ciaranmoore/TentaSense/Datasheets/ESP32 Thing Plus Pins.jpeg

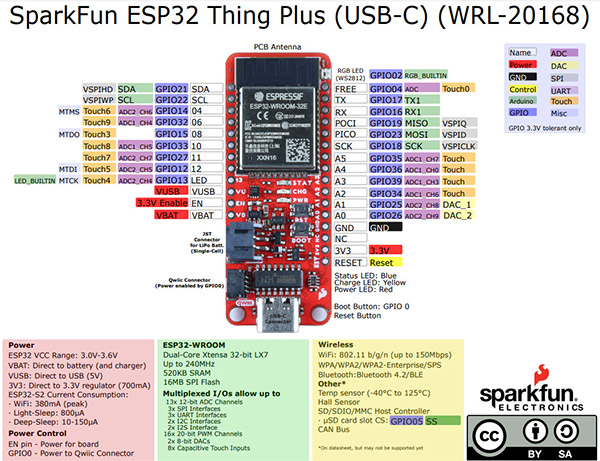
Datasheets/ESP32 Thing Plus Pins.jpeg
