ciaranmoore/TentaSense/Current Consumption/Sleep - 2.91 mAh:h.png

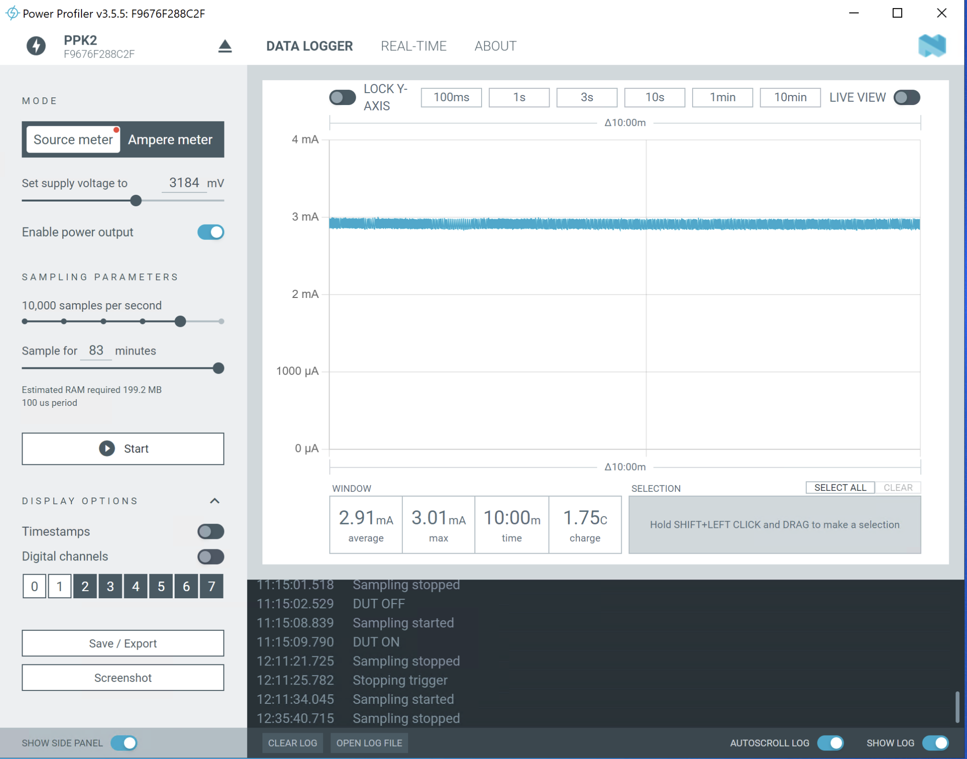
Current Consumption/Sleep - 2.91 mAh:h.png
