ciaranmoore/TentaSense/Current Consumption/Start-up - 0.6 mAh.png

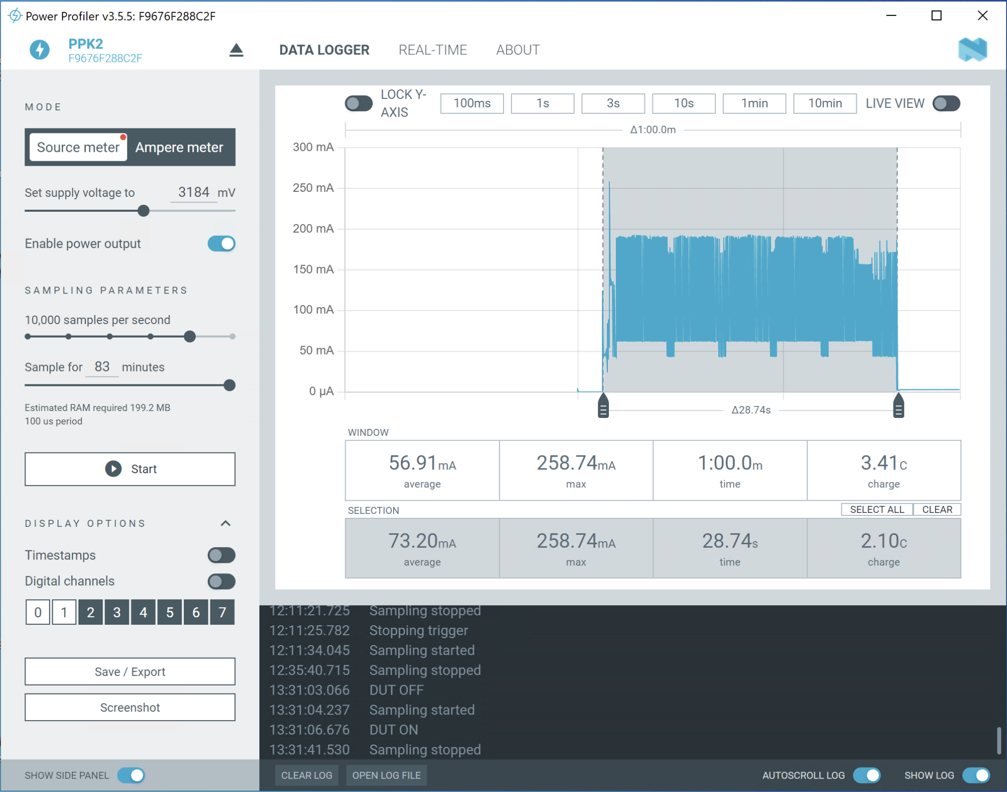
Current Consumption/Start-up - 0.6 mAh.png
