ciaranmoore/TentaSense/PCB/esp32-cp2102-programmer-schematic-for-espressif-esp32-esp8266.jpg

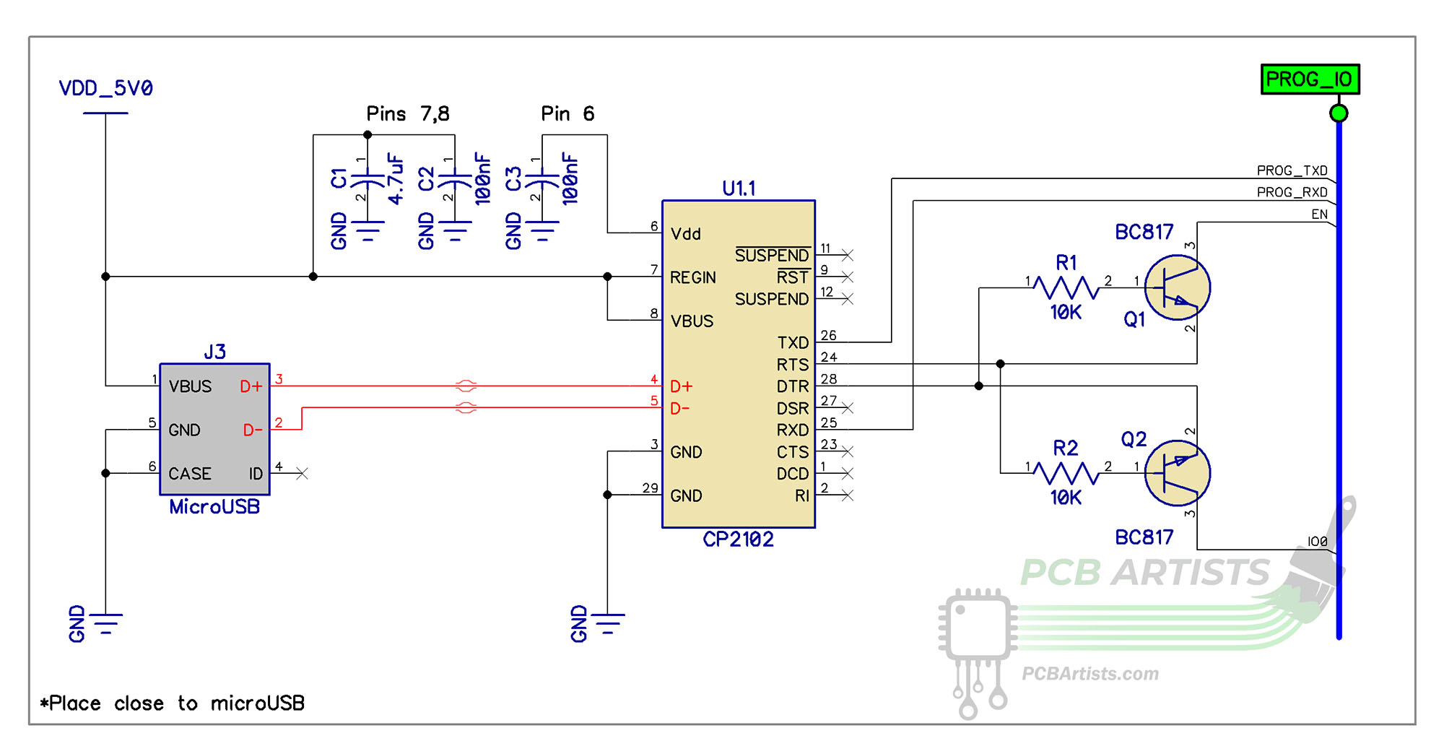
PCB/esp32-cp2102-programmer-schematic-for-espressif-esp32-esp8266.jpg
