ciaranmoore/TentaSense/PCB/Orchid.png

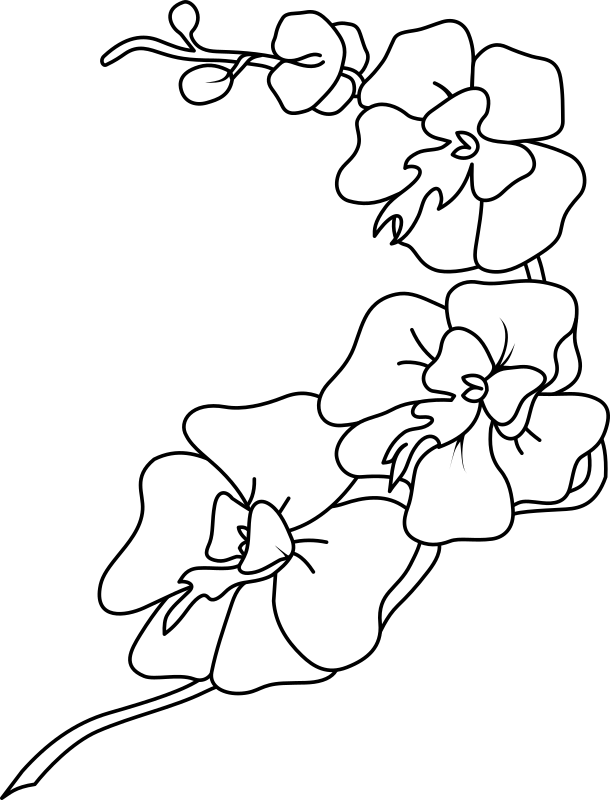
PCB/Orchid.png
