ciaranmoore/TentaSense/PCB/Footprints/ESP32-WROOM-32E__16MB_/ESP32-WROOM-32E__16MB_.step

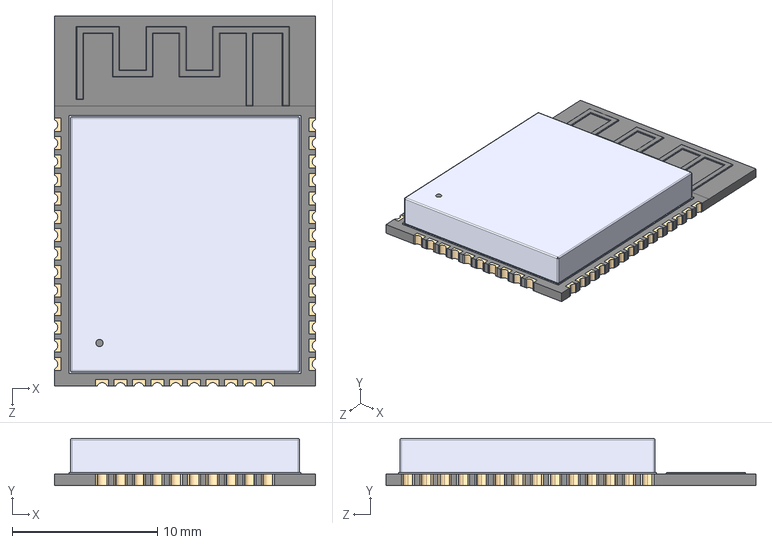
[picture p6: CAD file, 2024-07-01]
PCB/Footprints/ESP32-WROOM-32E__16MB_/ESP32-WROOM-32E__16MB_.step
18.0 x 3.25 x 25.5 mm
