ciaranmoore/TentaSense/PCB/Footprints/TL3305AF160QG/TL3305AF160QG.step

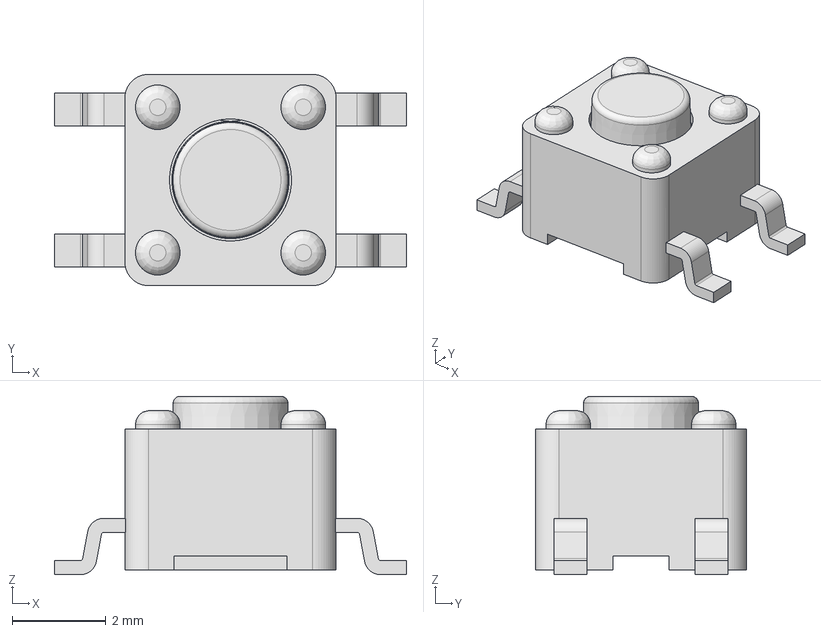
[picture p7: CAD file, 2024-07-01]
PCB/Footprints/TL3305AF160QG/TL3305AF160QG.step
7.50 x 4.50 x 3.80 mm
