ciaranmoore/TentaSense/Current Consumption/Current Measurement Method.rtf

Current consumption measurements taken for ESP32 Thing Plus C board powered at 3.184 V, connected to 3 × Adafruit AHT20 boards (with green LEDs).
Nordic PPK2 used in Source Meter mode.
Red power LED of the Thing Plus C is disabled.
