ciaranmoore/TentaSense/Current Consumption/Measurement - 12.3µAh.png

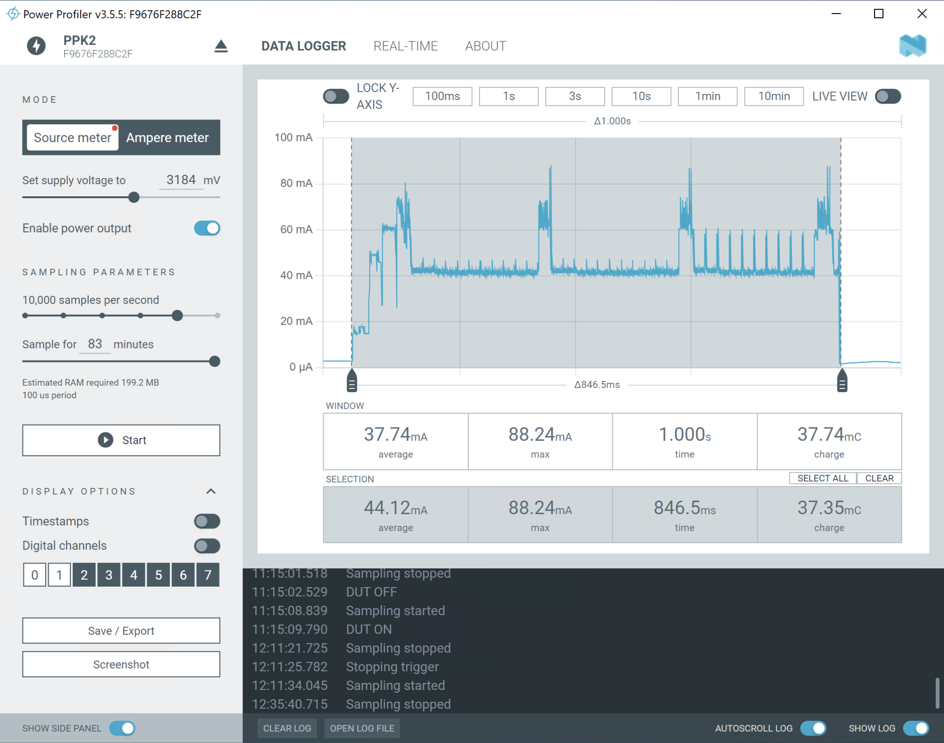
Current Consumption/Measurement - 12.3µAh.png
