ciaranmoore/TentaSense/PCB/RBOP04/Rigid Schematic.pdf

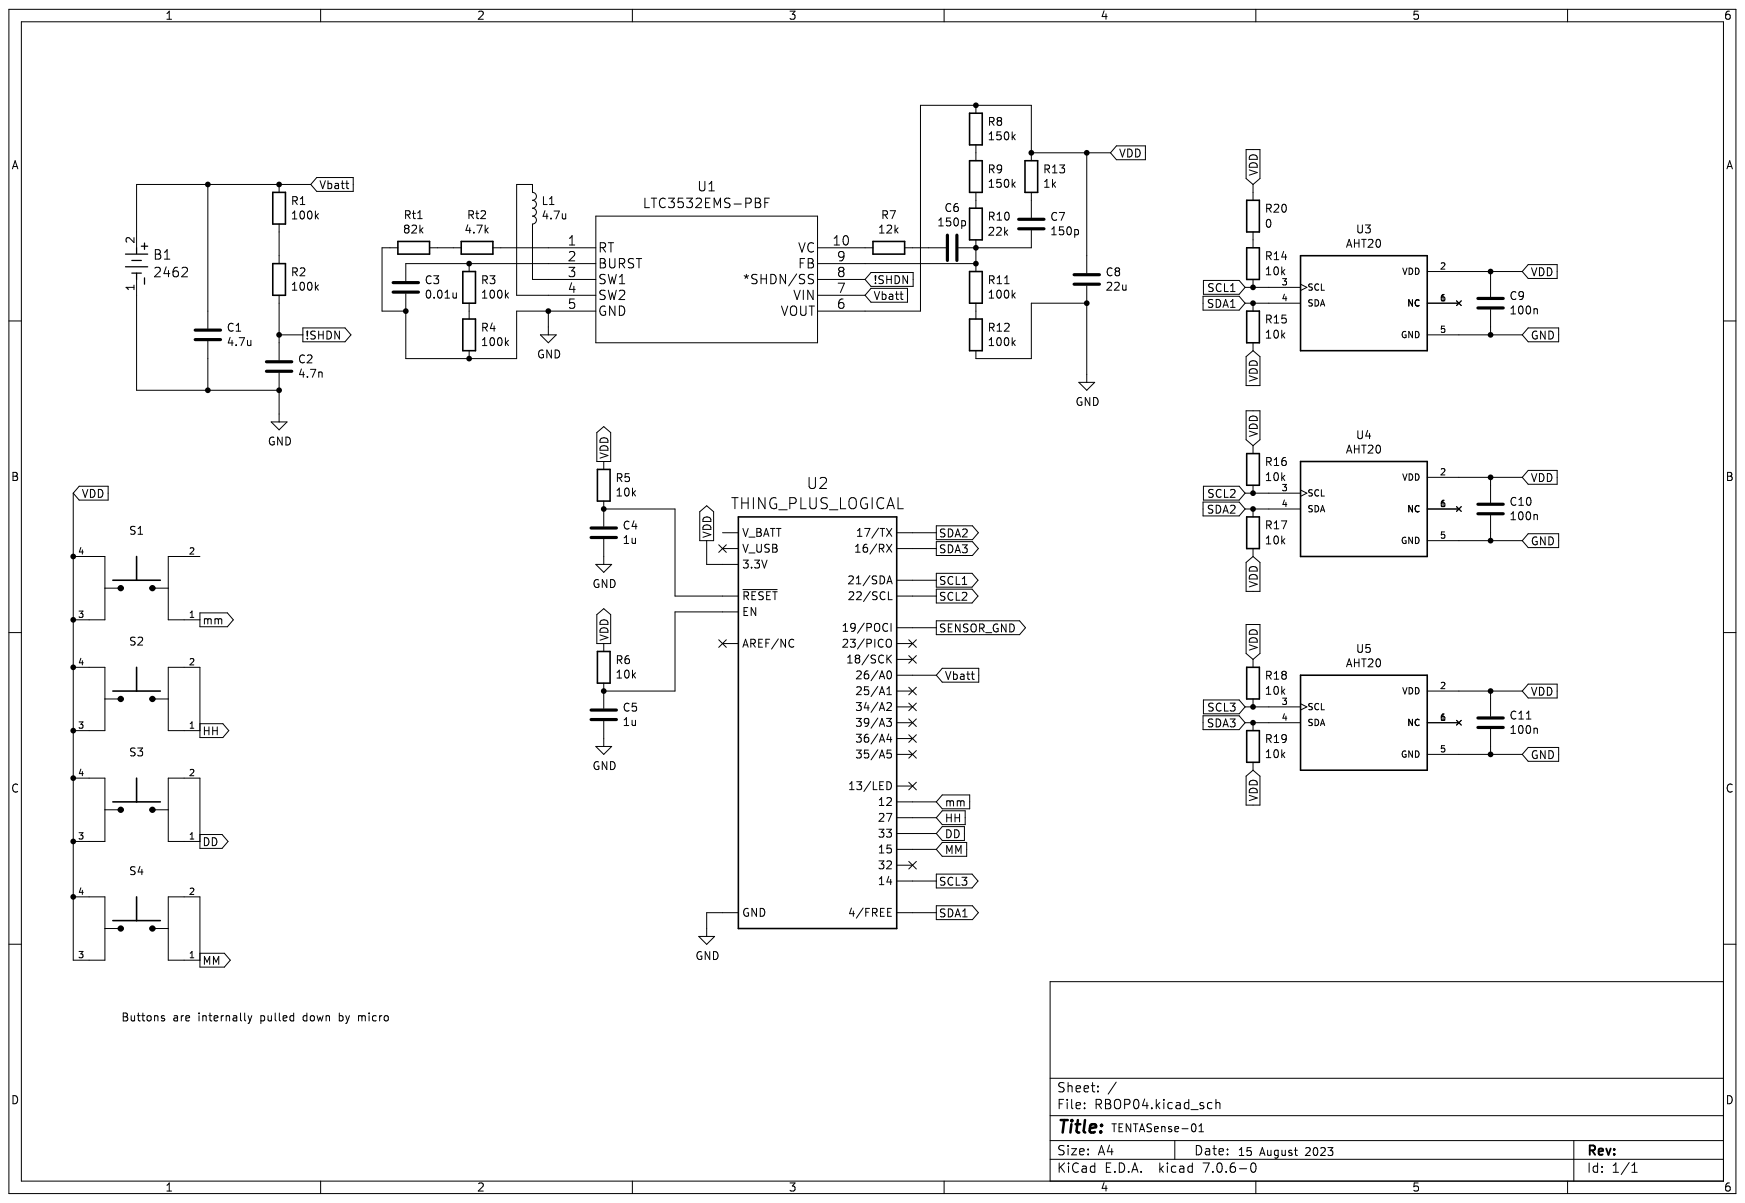
[picture p9: page 1]
