ciaranmoore/TentaSense/PCB/RBOP04_Flexible/Flexible Schematic.pdf

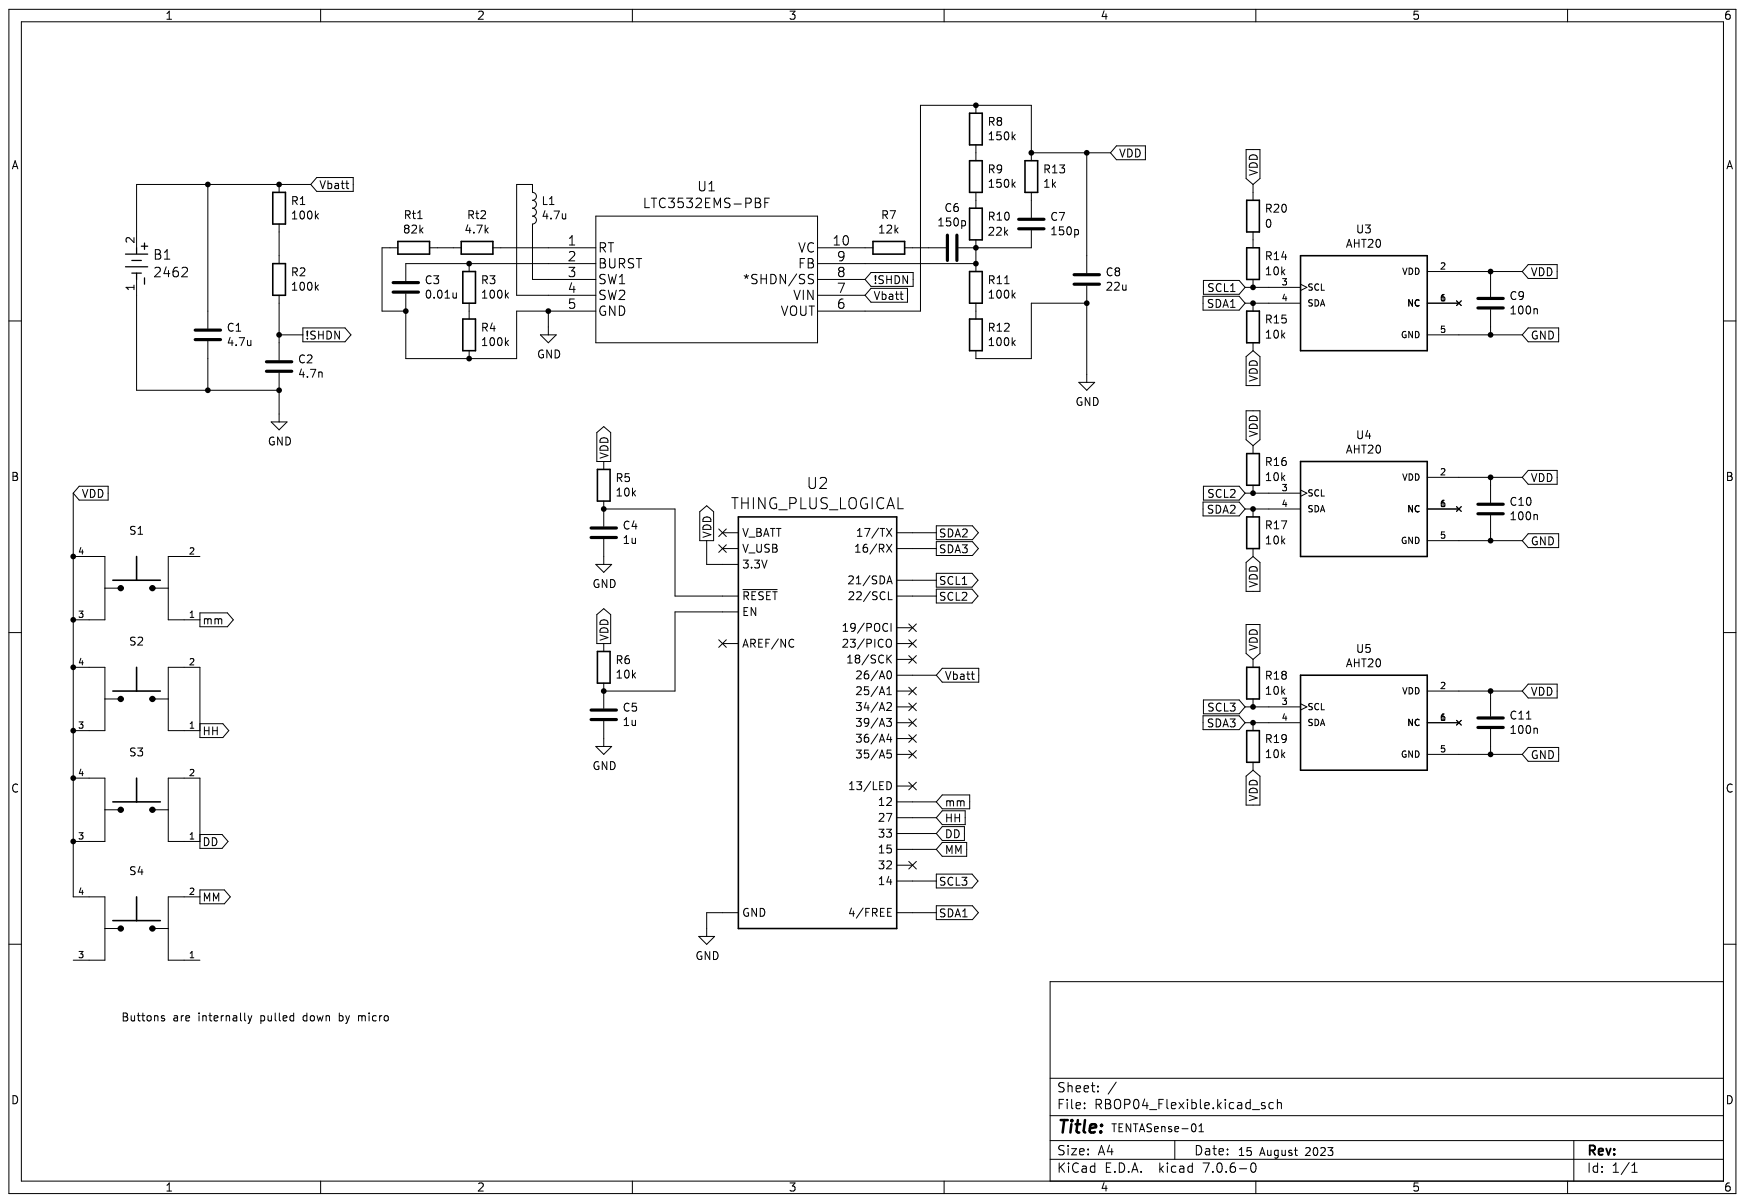
[picture p10: page 1]
