ciaranmoore/TentaSense/PCB/RBOP04/Rigid Layout.pdf

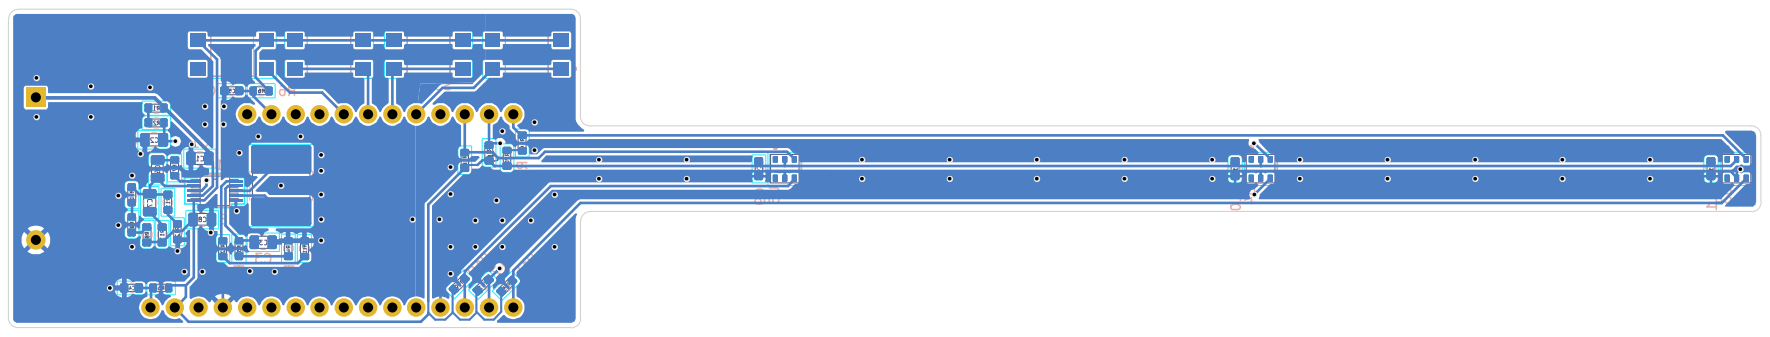
[picture p11: page 1]
