ciaranmoore/TentaSense/PCB/RBOP04_Flexible/Flexible Layout - Back.pdf

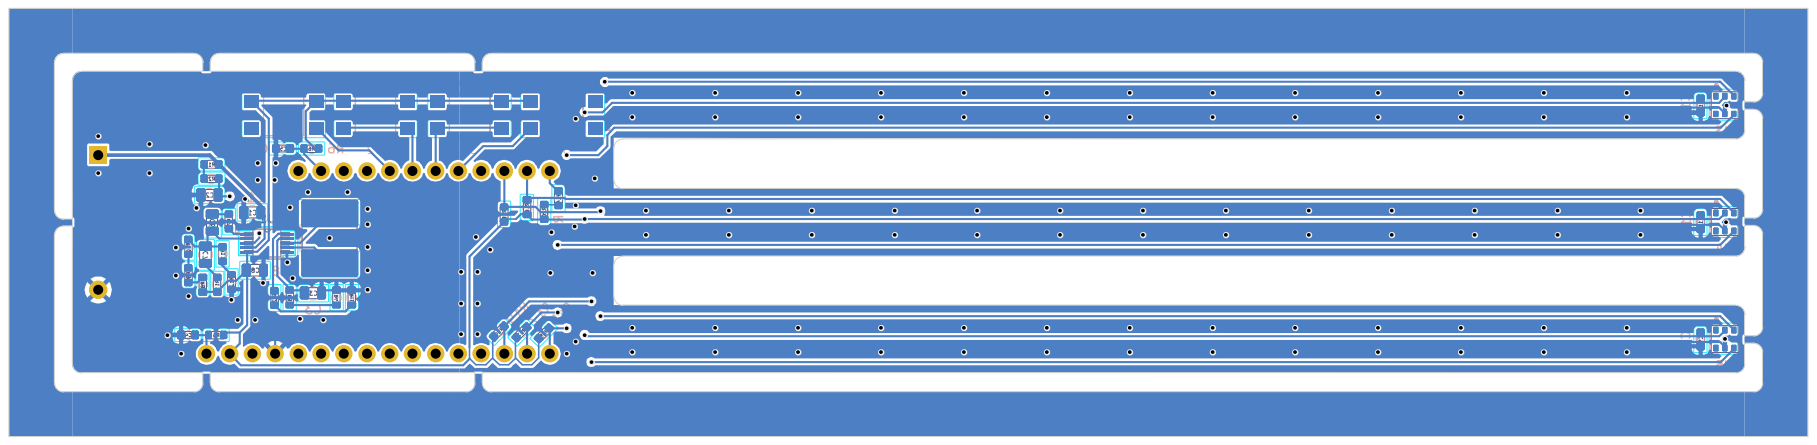
[picture p12: page 1]
