ciaranmoore/TentaSense/PCB/RBOP04_Flexible/Flexible Layout - Front.pdf

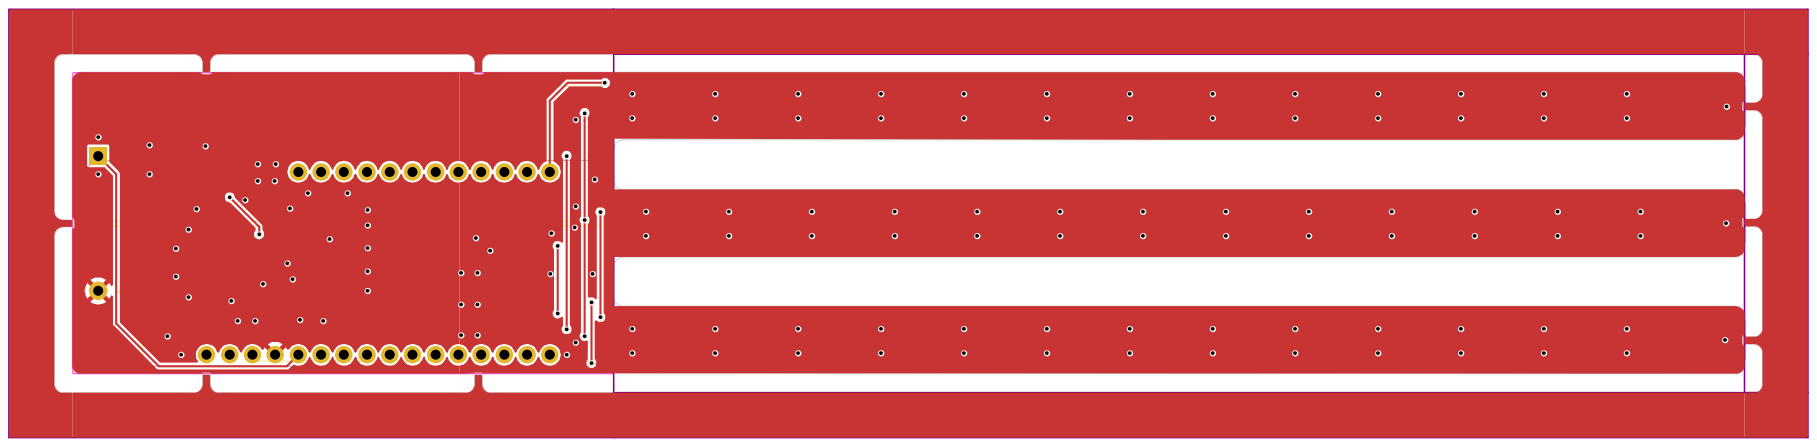
[picture p13: page 1]
