ciaranmoore/TentaSense/LTspice/LTC3532.asc

C1: cap; 4.7µ
C2: cap; 150p
C3: cap; 47µ
C4: cap; 150p
C5: cap; 4.7n
C6: cap; 22n
L1: ind; 4.7µ; Rser=26m
R1: res; 300k
R1a: res; {Rv}
R2: res; 200k
R3: res; 200k
R6: res; 12.1k
R7: res; 200k
R9: res; 1k
Rload: res; {RLOAD}
Rt: res; 86.6k
U1: LTC3532
V1: battery; {DCV}
Named nets: 0
.tran 0 3m 1m
Vout = 1.22V × (R8 + R9 + R5) / R5
.step param DCV list 2.7 3 3.3
.step param RLOAD list 1098, 33
.step param RLOAD list 2.5mA, 2.7mA, 3mA, 40mA, 60mA, 100mA
.step param DCV list 3 3.7
.PARAM RLOAD 1098
.step lin param RLOAD 100 1000 450
.param DCV 2.5
.step param Rv 22k 27k 5k
