ciaranmoore/TentaSense/PCB/RBOP04_Flexible/RBOP04_Flexible.kicad_pcb

## KiCad design PCB/RBOP04_Flexible/RBOP04_Flexible.kicad_pcb (2024-07-01)

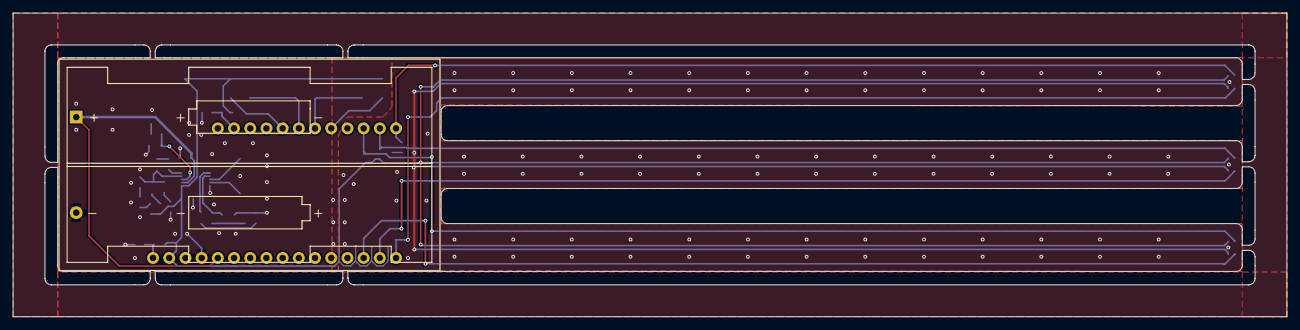
[picture p14: board RBOP04_Flexible.kicad_pcb from above]

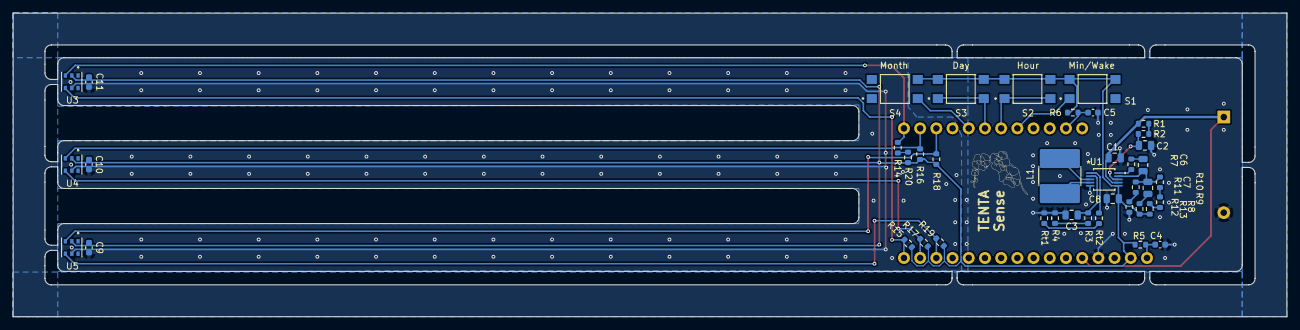
[picture p15: board RBOP04_Flexible.kicad_pcb from below]

Board: 2 copper layers, 199.7 x 47.6 mm, 44 parts (42 on the bottom side), 31 nets.

Parts:
B1: 2462; BatteryHolder_Keystone_2462_2xAA_CM
C1: 4.7u; C_0805_2012Metric
C2: 4.7n; C_0805_2012Metric
C3: 0.01u; C_0805_2012Metric
C4, C5: 1u; C_0603_1608Metric
C6, C7: 150p; C_0805_2012Metric
C8: 22u; C_0805_2012Metric
C9, C10, C11: 100n; C_0603_1608Metric
L1: 4.7u; L_2424_6060Metric
R1, R2, R3, R4, R11, R12: 100k; R_0603_1608Metric
R5, R6, R14, R15, R16, R17, R18, R19: 10k; R_0603_1608Metric
R7: 12k; R_0603_1608Metric
R8, R9: 150k; R_0603_1608Metric
R10: 22k; R_0603_1608Metric
R13: 1k; R_0603_1608Metric
R20: 0; R_0603_1608Metric
Rt1: 82k; R_0603_1608Metric
Rt2: 4.7k; R_0603_1608Metric
S1, S2, S3, S4: TL3305AF160QG; Button-CM
U1: LTC3532EMS-PBF; MSOP-10_MS_LIT
U2: THING_PLUS_LOGICAL; ESP32_Thing_Plus_C_hat
U3, U4, U5: AHT20; PSON100P300X300X110-6N

Connections:
!SHDN: C2.1, R2.2, U1.8 (*SHDN/SS)
DD: S3.1, S3.2, U2.6 (33)
GND: B1.1, C1.2, C2.2, C3.2, C4.2, C5.2, C8.2, C9.2, C10.2, C11.2, R4.2, R12.2, Rt1.2, U1.5 (GND), U2.25 (GND), U3.5 (GND), U4.5 (GND), U5.5 (GND)
HH: S2.1, S2.2, U2.7 (27)
MM: S4.2, U2.5 (15)
unnamed: C6.2, R7.1
unnamed: C7.1, R13.2
unnamed: R1.2, R2.1
unnamed: R3.2, R4.1
unnamed: R8.2, R9.1
unnamed: R9.2, R10.1
unnamed: R11.2, R12.1
unnamed: R14.1, R20.2
unnamed: Rt1.1, Rt2.2
unnamed: C3.1, R3.1, U1.2 (BURST)
unnamed: C6.1, C7.2, R10.2, R11.1, U1.9 (FB)
unnamed: Rt2.1, U1.1 (RT)
unnamed: L1.2, U1.3 (SW1)
unnamed: L1.1, U1.4 (SW2)
unnamed: R7.2, U1.10 (VC)
unnamed: C5.1, R6.2, U2.11 (EN)
unnamed: C4.1, R5.2, U2.28 (~RESET)
SCL1: R14.2, U2.1 (21/SDA), U3.3 (SCL)
SCL2: R16.2, U2.2 (22/SCL), U4.3 (SCL)
SCL3: R18.2, U2.3 (14), U5.3 (SCL)
SDA1: R15.1, U2.13 (4/FREE), U3.4 (SDA)
SDA2: R17.1, U2.14 (17/TX), U4.4 (SDA)
SDA3: R19.1, U2.15 (16/RX), U5.4 (SDA)
VDD: C8.1, C9.1, C10.1, C11.1, R5.1, R6.1, R8.1, R13.1, R15.2, R16.1, R17.2, R18.1, R19.2, R20.1, S1.3, S1.4, S2.3, S2.4, S3.3, S3.4, S4.4, U1.6 (VOUT), U2.27 (3.3V), U3.2 (VDD), U4.2 (VDD), U5.2 (VDD)
Vbatt: B1.2, C1.1, R1.1, U1.7 (VIN), U2.24 (26/A0)
mm: S1.1, U2.8 (12)
