ciaranmoore/TentaSense/PCB/Footprints/SparkFun_Thing_Plus_ESP32_WROOM_C_eagle_files2/SparkFun_Thing_Plus_ESP32_WROOM_C.brd

## EAGLE design PCB/Footprints/SparkFun_Thing_Plus_ESP32_WROOM_C_eagle_files2/SparkFun_Thing_Plus_ESP32_WROOM_C.brd (2024-07-01)

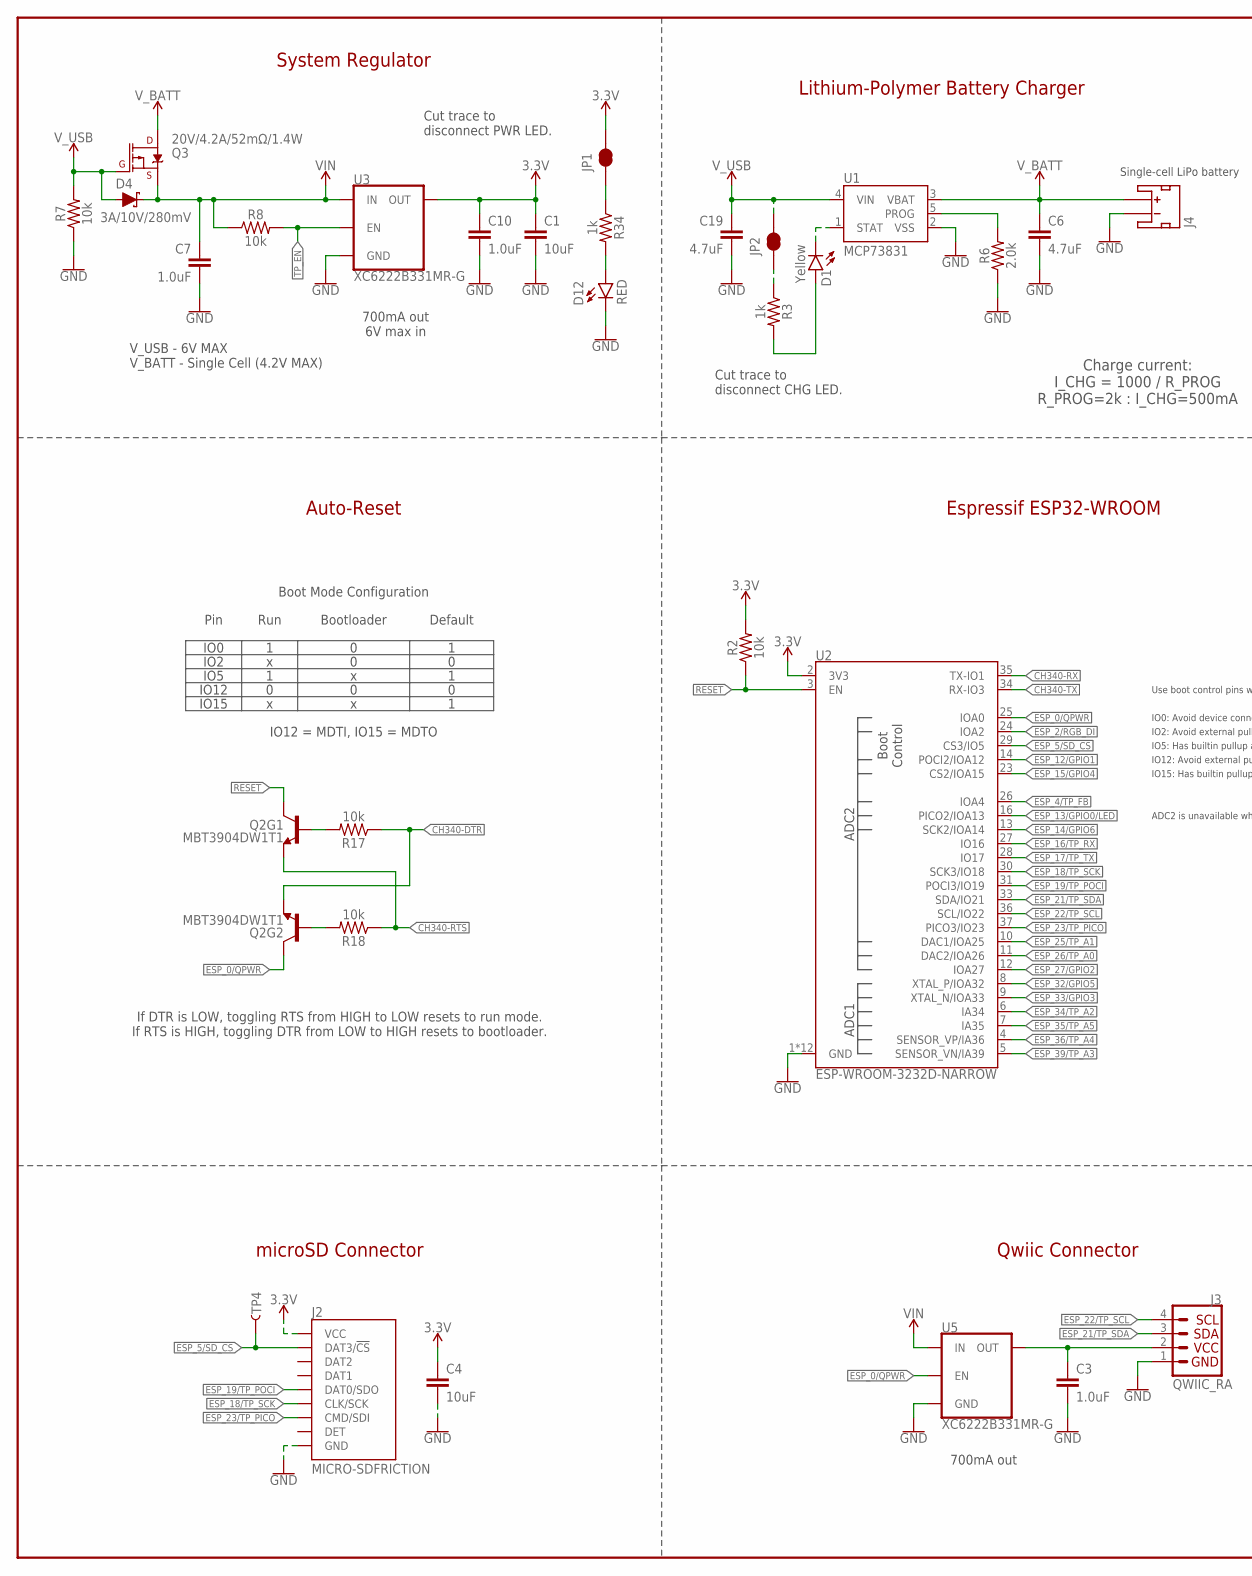
[picture p16: schematic SparkFun_Thing_Plus_ESP32_WROOM_C.sch, part in row 1, column 1]

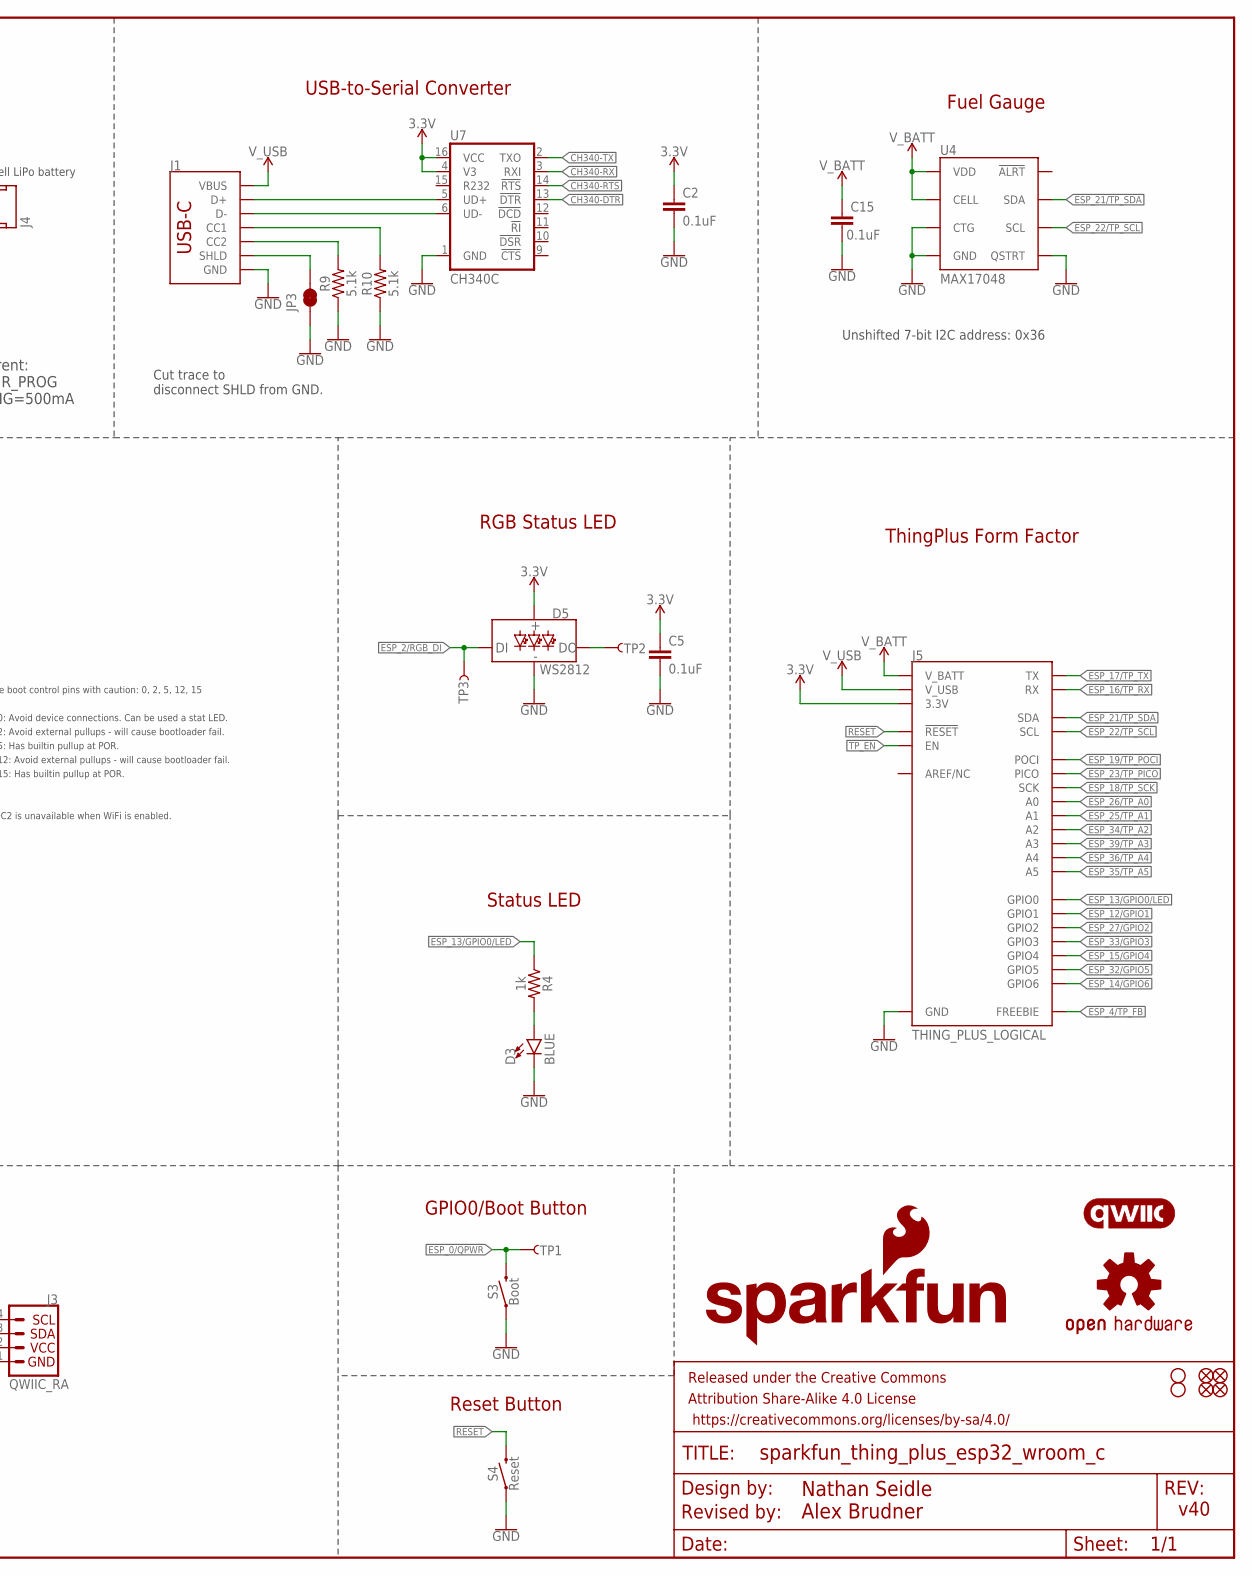
[picture p17: schematic SparkFun_Thing_Plus_ESP32_WROOM_C.sch, part in row 1, column 2]

Parts:
C1, C4: 10uF; 0402-TIGHT
C2, C5, C15: 0.1uF; 0402-TIGHT
C3, C7, C10: 1.0uF; 0402-TIGHT
C6: 4.7uF; 0402-TIGHT
C19: 4.7uF; 0603
D1: Yellow; LED-0603
D3: BLUE; LED-0603
D4: 3A/10V/280mV; SOD-323
D5: WS2812; WS2812-2020
D12: RED; LED-0603
FD1, FD2, FD3, FD4: FIDUCIALUFIDUCIAL; FIDUCIAL-MICRO
FRAME1: FRAME-LEDGER; CREATIVE_COMMONS
H1, H2: STAND-OFFTIGHT; STAND-OFF-TIGHT
J1: USB_C_2-LAYER_PADS; USB-C-16P-2LAYER-PADS
J2: MICRO-SDFRICTION; MICROSD_TINY
J3: QWIIC_RA; JST04_1MM_RA
J4: JST_2MM_MALE; JST-2-SMD
J5: THING_PLUS_LOGICAL; THING_PLUS
JP1, JP2, JP3: JUMPER-SMT_2_NC_TRACE_SILK; SMT-JUMPER_2_NC_TRACE_SILK
LOGO1: SFE_LOGO_NAME_FLAME.1_INCH; SFE_LOGO_NAME_FLAME_.1
LOGO2: OSHW-LOGOMINI; OSHW-LOGO-MINI
LOGO4: QWIIC_LOGO_4MM; QWIIC_4MM
Q2: MBT3904DW1T1; SC70-6
Q3: 20V/4.2A/52mΩ/1.4W; SOT23-3
R2, R7, R8, R17, R18: 10k; 0402-TIGHT
R3, R4, R34: 1k; 0402-TIGHT
R6: 2.0k; 0603
R9, R10: 5.1k; 0402-TIGHT
S3: Boot; TACTILE_SWITCH_SMD_4.6X2.8MM
S4: Reset; TACTILE_SWITCH_SMD_4.6X2.8MM
TP1, TP2, TP3, TP4: TEST-POINT3X5; PAD.03X.05
U1: MCP73831; SOT23-5
U2: ESP-WROOM-3232D-NARROW; ESP-WROOM-32D-NARROW
U3, U5: XC6222B331MR-G; SOT23-5
U4: MAX17048; DFN-8
U7: CH340C; SO016

Connections:
3.3V: C1.1, C2.1, C4.1, C5.1, C10.1, D5.VCC, J2.4 (VCC), J5.27 (3.3V), JP1.2, R2.2, U2.2 (3V3), U3.5 (OUT), U7.4 (V3), U7.16 (VCC)
!RESET!: J5.28 (!RESET), Q2.3 (C), R2.1, S4.3 (2), S4.4 (2), U2.3 (EN)
CH340-DTR: Q2.1 (E), R17.1, U7.13 (!DTR)
CH340-RTS: Q2.4 (E), R18.1, U7.14 (!RTS)
CH340-RX: U2.35 (TX-IO1), U7.3 (RXI)
CH340-TX: U2.34 (RX-IO3), U7.2 (TXO)
CHG_LED: D1.A, R3.2
D+: J1.A6 (D+), J1.B6 (D+), U7.5 (UD+)
D-: J1.A7 (D-), J1.B7 (D-), U7.6 (UD-)
DTR-10K: Q2.5 (B), R17.2
ESP_0/QPWR: Q2.6 (C), S3.3 (2), S3.4 (2), TP1.1, U2.25 (IOA0), U5.3 (EN)
ESP_2/RGB_DI: D5.DI, TP3.1, U2.24 (IOA2)
ESP_4/TP_FB: J5.13 (FREEBIE), U2.26 (IOA4)
ESP_5/SD_CS: J2.2 (DAT3/!CS!), TP4.1, U2.29 (CS3/IO5)
ESP_12/GPIO1: J5.8 (GPIO1), U2.14 (POCI2/IOA12)
ESP_13/GPIO0/LED: J5.9 (GPIO0), R4.1, U2.16 (PICO2/IOA13)
ESP_14/GPIO6: J5.3 (GPIO6), U2.13 (SCK2/IOA14)
ESP_15/GPIO4: J5.5 (GPIO4), U2.23 (CS2/IOA15)
ESP_16/TP_RX: J5.15 (RX), U2.27 (IO16)
ESP_17/TP_TX: J5.14 (TX), U2.28 (IO17)
ESP_18/TP_SCK: J2.5 (CLK/SCK), J5.18 (SCK), U2.30 (SCK3/IO18)
ESP_19/TP_POCI: J2.7 (DAT0/SDO), J5.16 (POCI), U2.31 (POCI3/IO19)
ESP_21/TP_SDA: J3.3, J5.1 (SDA), U2.33 (SDA/IO21), U4.8 (SDA)
ESP_22/TP_SCL: J3.4, J5.2 (SCL), U2.36 (SCL/IO22), U4.7 (SCL)
ESP_23/TP_PICO: J2.3 (CMD/SDI), J5.17 (PICO), U2.37 (PICO3/IO23)
ESP_25/TP_A1: J5.23 (A1), U2.10 (DAC1/IOA25)
ESP_26/TP_A0: J5.24 (A0), U2.11 (DAC2/IOA26)
ESP_27/GPIO2: J5.7 (GPIO2), U2.12 (IOA27)
ESP_32/GPIO5: J5.4 (GPIO5), U2.8 (XTAL_P/IOA32)
ESP_33/GPIO3: J5.6 (GPIO3), U2.9 (XTAL_N/IOA33)
ESP_34/TP_A2: J5.22 (A2), U2.6 (IA34)
ESP_35/TP_A5: J5.19 (A5), U2.7 (IA35)
ESP_36/TP_A4: J5.20 (A4), U2.4 (SENSOR_VP/IA36)
ESP_39/TP_A3: J5.21 (A3), U2.5 (SENSOR_VN/IA39)
GND: C1.2, C2.2, C3.2, C4.2, C5.2, C6.2, C7.2, C10.2, C15.2, C19.2, D3.C, D5.GND, D12.C, J1.GND, J1.GND2 (GND), J2.6 (GND), J2.GND1 (GND), J2.GND2 (GND), J2.GND3 (GND), J2.GND4 (GND), J2.GND5 (GND), J2.GND6 (GND), J3.1, J4.1 (-), J5.25 (GND), JP3.1, R6.1, R7.1, R9.1, R10.1, S3.1, S3.2 (1), S4.1, S4.2 (1), U1.2 (VSS), U2.1 (GND), U2.15 (GND), U2.38 (GND), U2.GND1 (GND), U2.GNDT1 (GND), U2.GNDT2 (GND), U2.GNDT3 (GND), U2.GNDT4 (GND), U2.GNDT5 (GND), U2.GNDT6 (GND), U2.GNDT7 (GND), U2.GNDT8 (GND), U3.2 (GND), U4.1 (CTG), U4.4 (GND), U4.6 (QSTRT), U4.9 (GND), U5.2 (GND), U7.1 (GND)
unnamed: JP1.1, R34.1
unnamed: D3.A, R4.2
unnamed: D5.DO, TP2.1
unnamed: JP2.1, R3.1
unnamed: J1.B5 (CC2), R9.2
unnamed: J1.A5 (CC1), R10.2
unnamed: D1.C, U1.1 (STAT)
unnamed: J1.SHLD1 (SHLD), J1.SHLD2 (SHLD), J1.SHLD3 (SHLD), J1.SHLD4 (SHLD), JP3.2
unnamed: R6.2, U1.5 (PROG)
unnamed: D12.A, R34.2
QWIIC_PWR: C3.1, J3.2, U5.5 (OUT)
RTS-10K: Q2.2 (B), R18.2
TP_EN: J5.11 (EN), R8.2, U3.3 (EN)
VIN: C7.1, D4.C, Q3.2 (S), R8.1, U3.1 (IN), U5.1 (IN)
V_BATT: C6.1, C15.1, J4.2 (+), J5.12 (V_BATT), Q3.3 (D), U1.3 (VBAT), U4.2 (CELL), U4.3 (VDD)
V_USB: C19.1, D4.A, J1.VBUS1 (VBUS), J1.VBUS2 (VBUS), J5.10 (V_USB), JP2.2, Q3.1 (G), R7.2, U1.4 (VIN)

Notes on the sheet:
USB-to-Serial Converter
Single-cell LiPo battery
Charge current: I_CHG = 1000 / R_PROG R_PROG=2k : I_CHG=500mA
System Regulator
Lithium-Polymer Battery Charger
700mA out 6V max in
Auto-Reset
Espressif ESP32-WROOM
Reset Button
ThingPlus Form Factor
v40
If DTR is LOW, toggling RTS from HIGH to LOW resets to run mode. If RTS is HIGH, toggling DTR from LOW to HIGH resets to bootloader.
Qwiic Connector
Status LED
GPIO0/Boot Button
V_USB - 6V MAX V_BATT - Single Cell (4.2V MAX)
Pin
IO0
IO2
IO12
IO15
IO5
Run
Bootloader
Default
IO12 = MDTI, IO15 = MDTO
Boot Mode Configuration
IO0: Avoid device connections. Can be used a stat LED.
ADC2 is unavailable when WiFi is enabled.
IO12: Avoid external pullups - will cause bootloader fail.
Use boot control pins with caution: 0, 2, 5, 12, 15
IO2: Avoid external pullups - will cause bootloader fail.
Fuel Gauge
700mA out
RGB Status LED
microSD Connector
IO15: Has builtin pullup at POR.
IO5: Has builtin pullup at POR.
Cut trace to disconnect CHG LED.
Cut trace to disconnect PWR LED.
Cut trace to disconnect SHLD from GND.
Unshifted 7-bit I2C address: 0x36

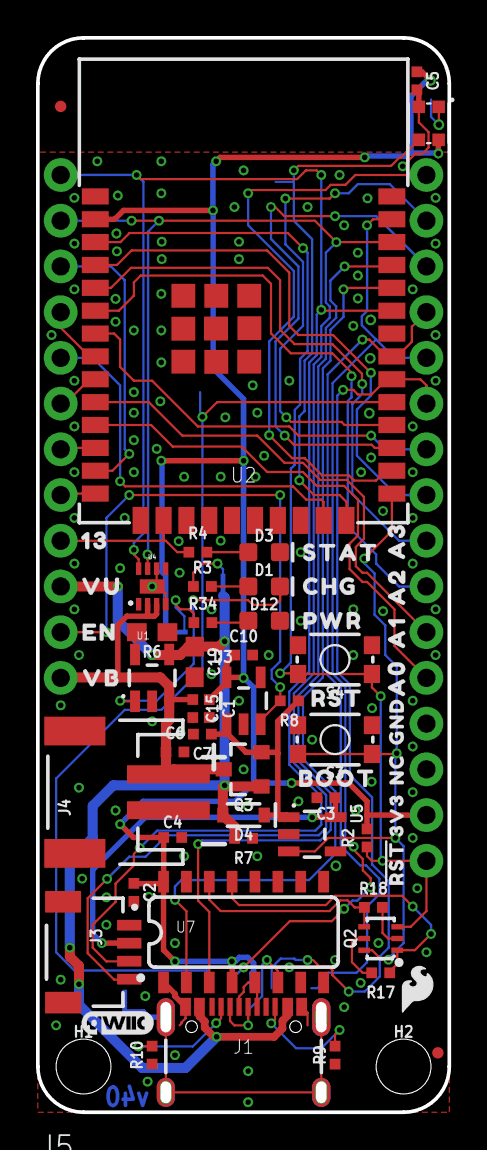
[picture p18: board SparkFun_Thing_Plus_ESP32_WROOM_C.brd from above]

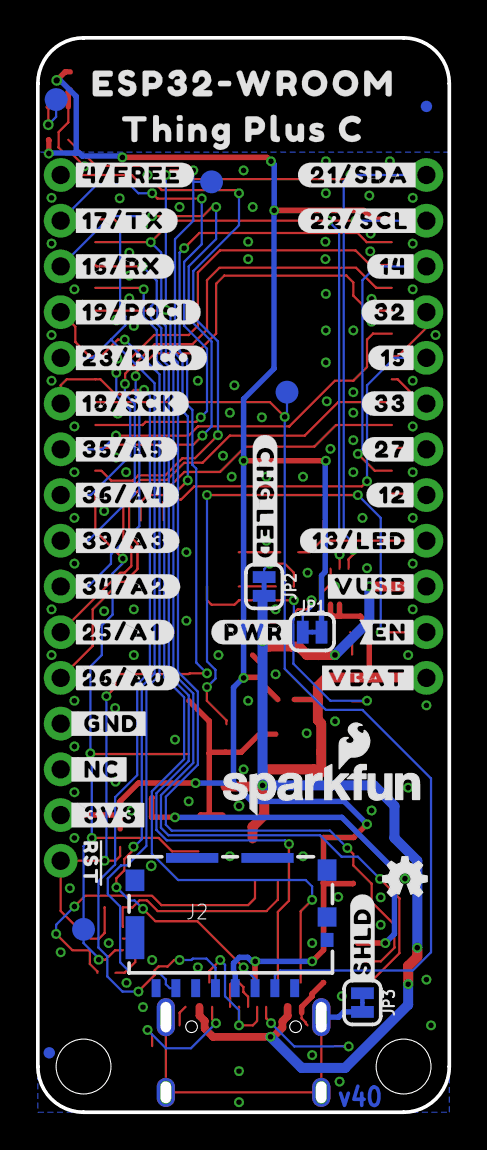
[picture p19: board SparkFun_Thing_Plus_ESP32_WROOM_C.brd from below]

Board: 2 copper layers, 22.9 x 59.7 mm, 110 parts (46 on the bottom side), 51 nets.

Other parts of the board:
U$1: SFE_LOGO_FLAME_STOP_.1
U$2: #23#PICO#0
U$3: #19#POCI#0
U$4: #4#FREE#0
U$5: #CHG_LED#0
U$6: ESP32#WROOM0
U$7: THING_PLUS_C0
U$8: #SHLD#0
U$9: #_GND#0
U$10: #_NC#0
U$11: #_3V3#0
U$12: SFE_LOGO_FLAME_.1
U$23: 3V30
U$24: CHG1
U$25: PWR2
U$26: STAT0
U$68: A03
U$69: A12
U$70: A21
U$71: A30
U$72: #17#TX#0
U$73: VB1
U$74: EN3
U$75: GND1
U$76: VU0
U$77: 130
U$78: BOOT0
U$79, U$109: #RST#0
U$80: RST0
U$81: #16#RX#0
U$83: #18#SCK#0
U$84: #35#A5#0
U$85: #36#A4#0
U$86: #25#A1#2
U$87: #26#A0#3
U$88: #34#A2#1
U$89: #39#A3#0
U$90: #12#4
U$91: #14#9
U$92: #15#7
U$93: #27#5
U$94: #32#8
U$95: #33#6
U$96: #EN#1
U$97: #VBAT#0
U$98: #VUSB#2
U$99: #13#LED#0
U$100: #21#SDA#1
U$101: #22#SCL#0
U$102: #PWR#0
U$107: NC0
