ciaranmoore/TentaSense/sketches/ESP32_bring_up - to Heiana 2023-06-26/AHT201.h

#ifndef __AHT201_H__
#define __AHT201_H__

#include <Arduino.h>
#include <Wire.h>

class AHT201{
    
private:

    bool startSensor();
public:

    void begin();
    bool getSensor(float *h, float *t);
    bool getTemperature(float *t);
    bool getHumidity(float *h);
};

#endif
